C15JOSUEJOEL/CONTROL-PID-AGRO---ElECTIVA/KiCAD - Circuitos y Placas/Captura de pantalla 2026-10-22 052648.png

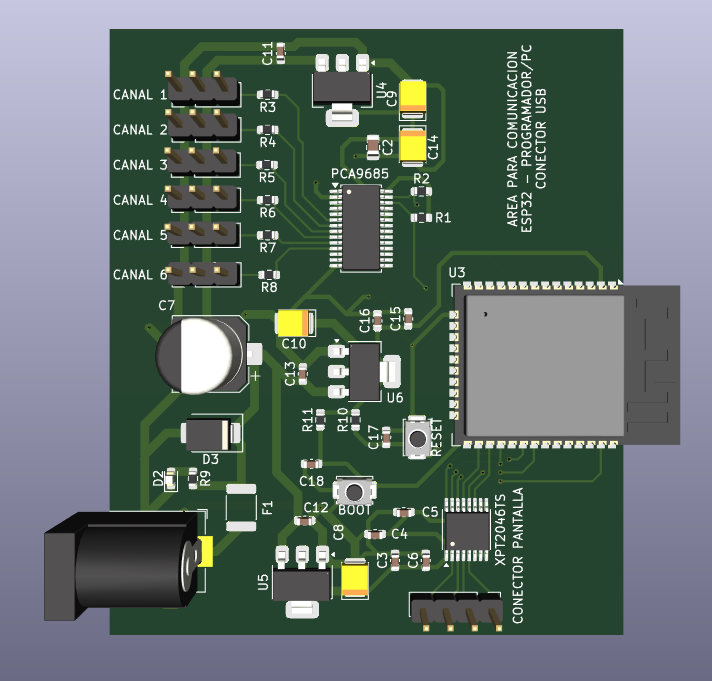
KiCAD - Circuitos y Placas/Captura de pantalla 2026-10-22 052648.png
