C15JOSUEJOEL/CONTROL-PID-AGRO---ElECTIVA/EQUIPO/Portafolio de Tareas/README

Esta seccion es un archivero para las tareas independiente o como practicas del equipo con el fin de conocer nuevos softwares durante el desarrollo del Producto AGRO
