C15JOSUEJOEL/CONTROL-PID-AGRO---ElECTIVA/EQUIPO/Portafolio de Tareas/Josue Castro, 2023-0874/CAJA de discos (Josue Castro, 2023-0874)/Piezas por partes/README

Josue Castro, 2023-0874
Adjunto partes de caja de discos y su ensamble
