C15JOSUEJOEL/CONTROL-PID-AGRO---ElECTIVA/KiCAD - Circuitos y Placas/Recursos/KH-TYPE-C-16P_kinghelm.pdf

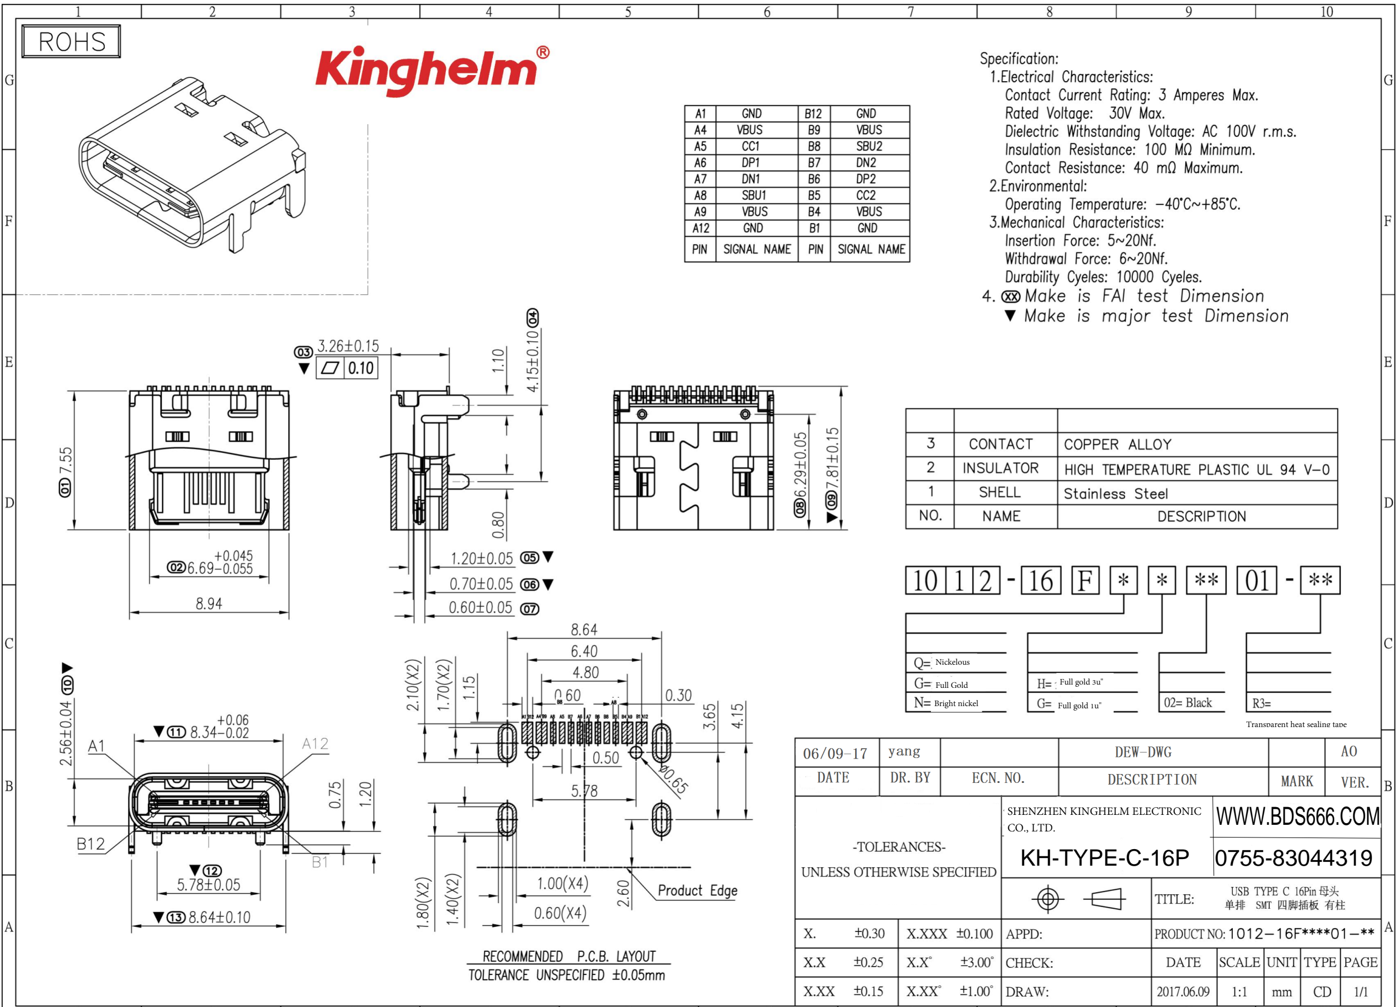
[picture p3: page 1]

深圳市金航标电子有限公司 WWW.BDS666.COM KH-TYPE-C-16P 0755-83044319
