C15JOSUEJOEL/CONTROL-PID-AGRO---ElECTIVA/Diseños 3D (FreeCad y Solid)/Refrencia para los brazos de los Servos.jpeg

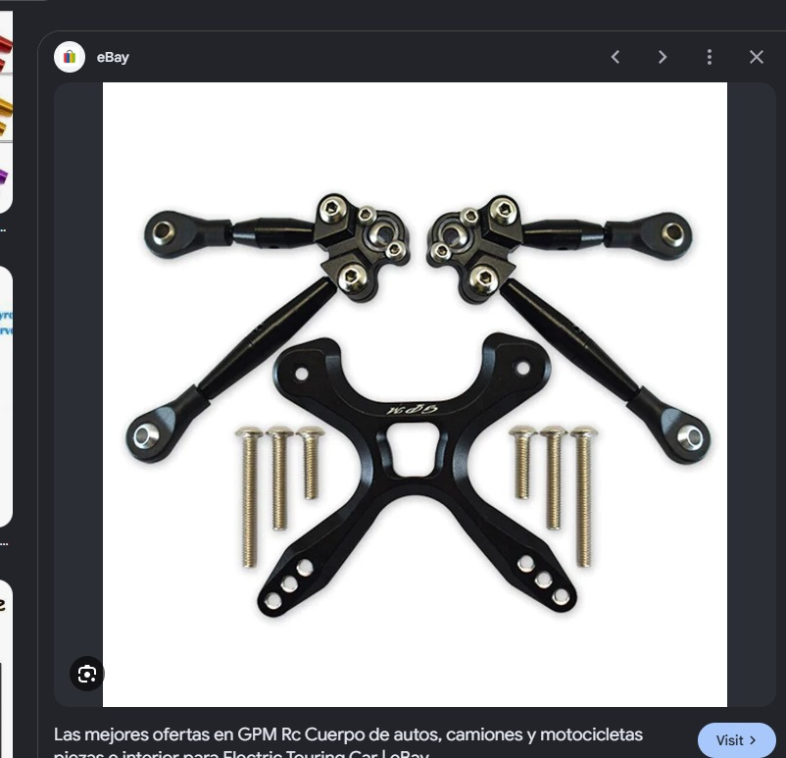
Diseños 3D (FreeCad y Solid)/Refrencia para los brazos de los Servos.jpeg
