C15JOSUEJOEL/CONTROL-PID-AGRO---ElECTIVA/EQUIPO/Portafolio de Tareas/Josue Castro, 2023-0874/CAJA de discos (Josue Castro, 2023-0874)/imagen_2026-10-20_183322660.png

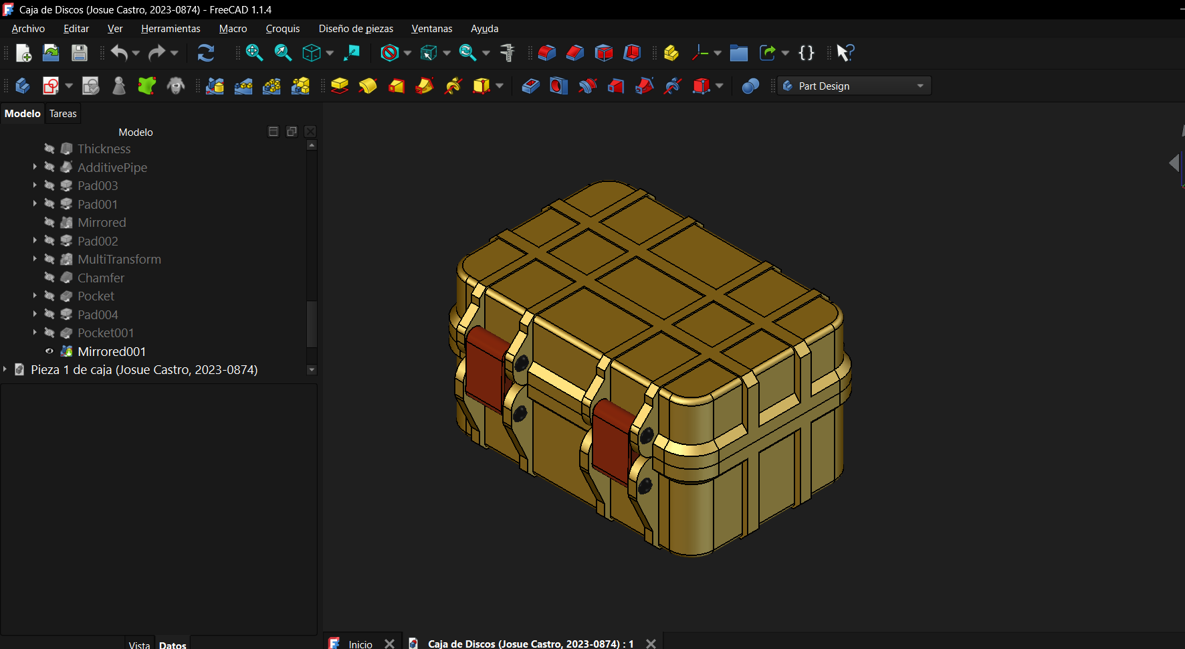
EQUIPO/Portafolio de Tareas/Josue Castro, 2023-0874/CAJA de discos (Josue Castro, 2023-0874)/imagen_2026-10-20_183322660.png
