C15JOSUEJOEL/CONTROL-PID-AGRO---ElECTIVA/KiCAD - Circuitos y Placas/Captura de pantalla 2026-11-11 192054.png

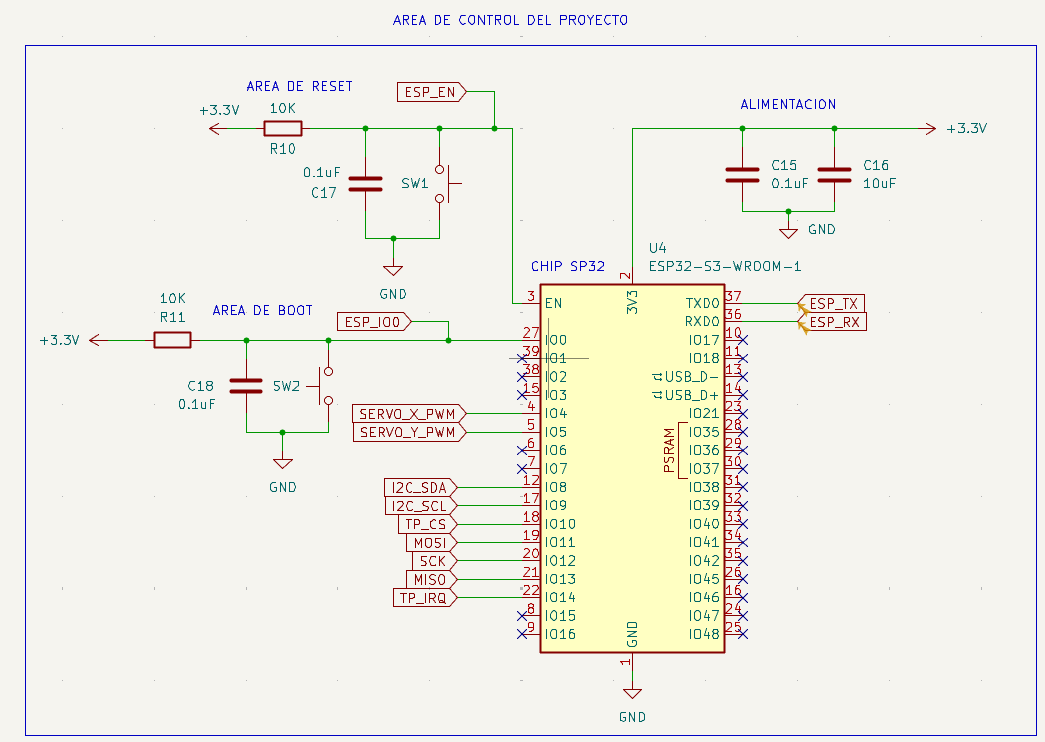
KiCAD - Circuitos y Placas/Captura de pantalla 2026-11-11 192054.png
