C15JOSUEJOEL/CONTROL-PID-AGRO---ElECTIVA/Portafolio de Tareas/Josue Castro, 2023-0874/CAJA de discos (Josue Castro, 2023-0874)/imagen_2026-10-20_184822248.png

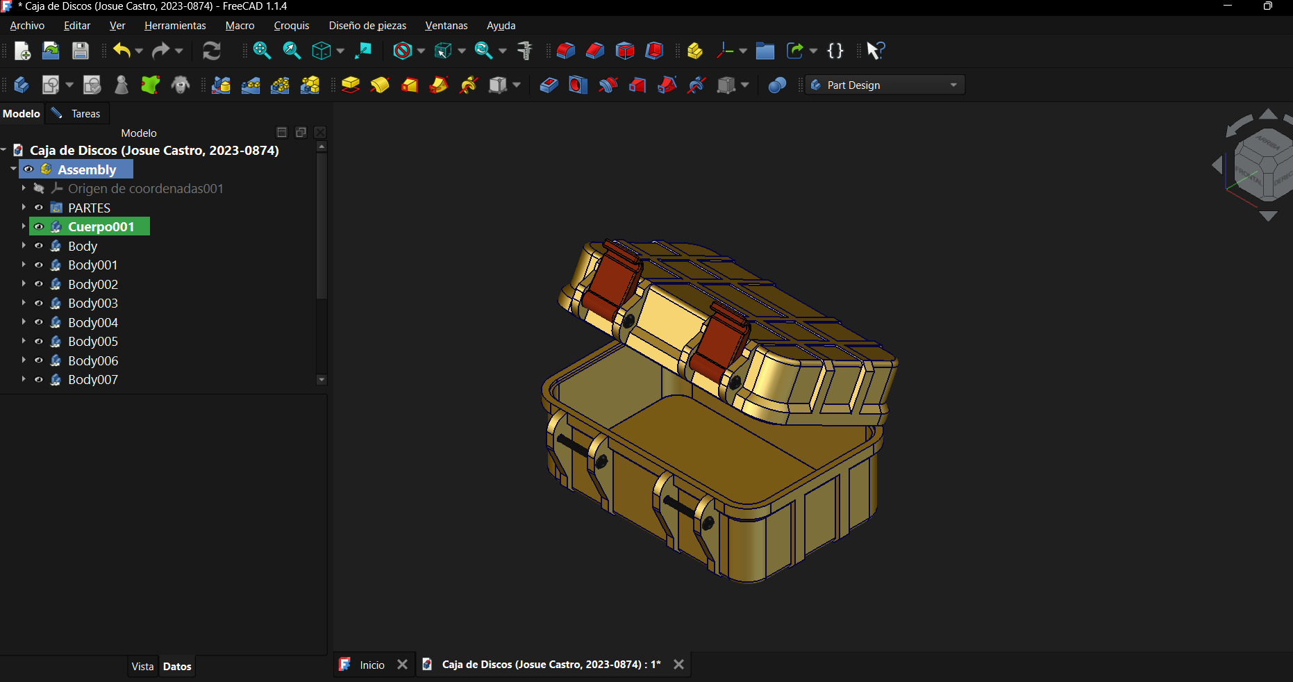
Portafolio de Tareas/Josue Castro, 2023-0874/CAJA de discos (Josue Castro, 2023-0874)/imagen_2026-10-20_184822248.png
