C15JOSUEJOEL/CONTROL-PID-AGRO---ElECTIVA/Portafolio de Tareas/Josue Castro, 2023-0874/Caja de Tronillos FreeCAD (Josue Castro, 2023-0874)/imagen_2026-10-21_192811558.png

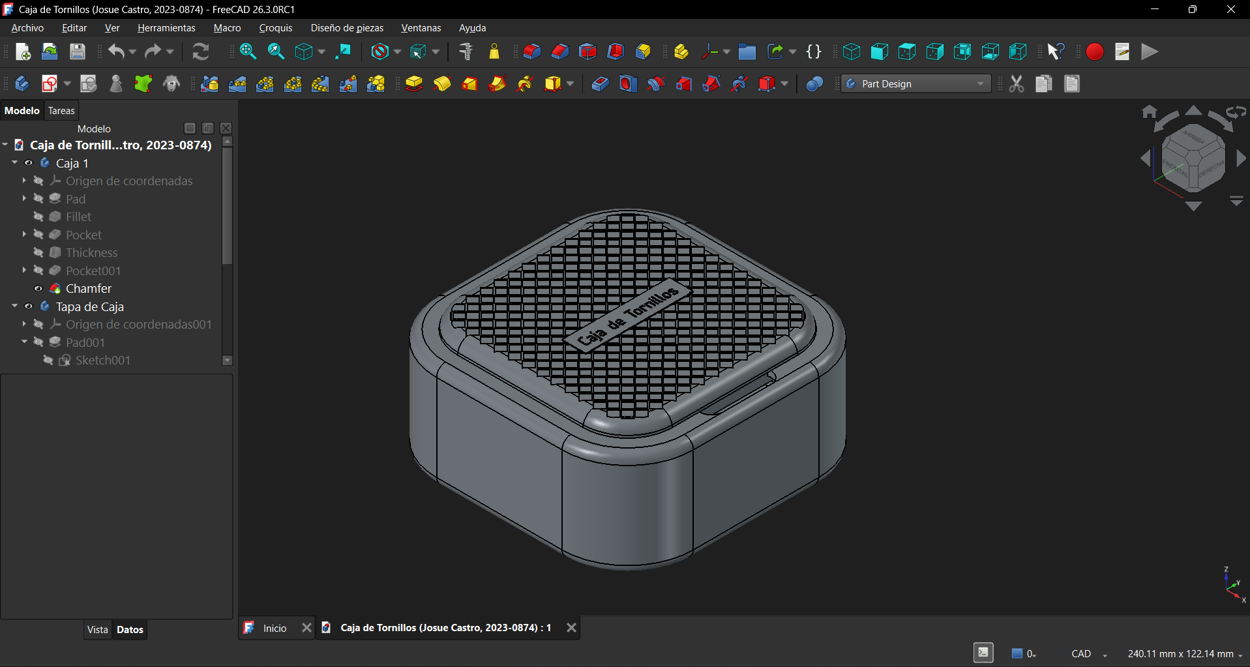
Portafolio de Tareas/Josue Castro, 2023-0874/Caja de Tronillos FreeCAD (Josue Castro, 2023-0874)/imagen_2026-10-21_192811558.png
