C15JOSUEJOEL/CONTROL-PID-AGRO---ElECTIVA/Diseños 3D (FreeCad y Solid)/Prueba PIB.STEP

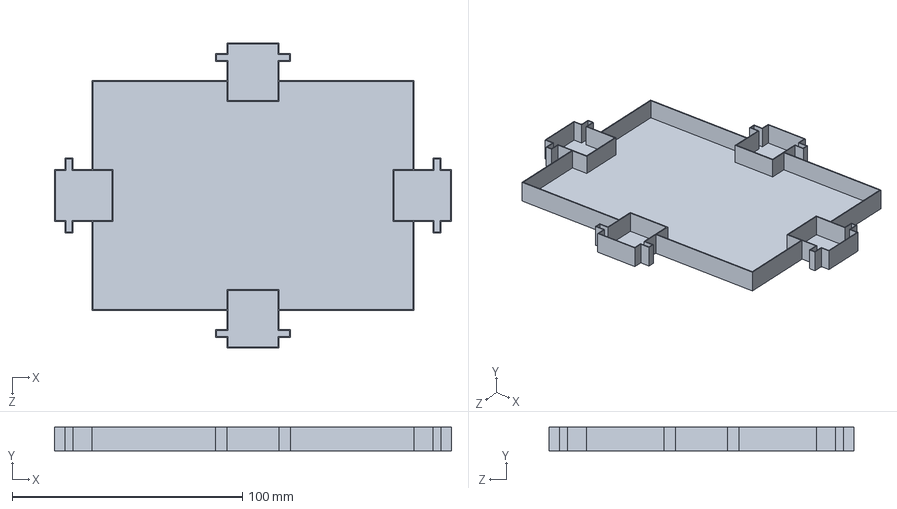
[picture p14: CAD file, 2026-11-14]
Diseños 3D (FreeCad y Solid)/Prueba PIB.STEP
172.6 x 10.3 x 132.6 mm
