C15JOSUEJOEL/CONTROL-PID-AGRO---ElECTIVA/EQUIPO/Portafolio de Tareas/Josue Castro, 2023-0874/CAJA de discos (Josue Castro, 2023-0874)/Piezas por partes/Pieza 1 de caja (Josue Castro, 2023-0874).FCStd

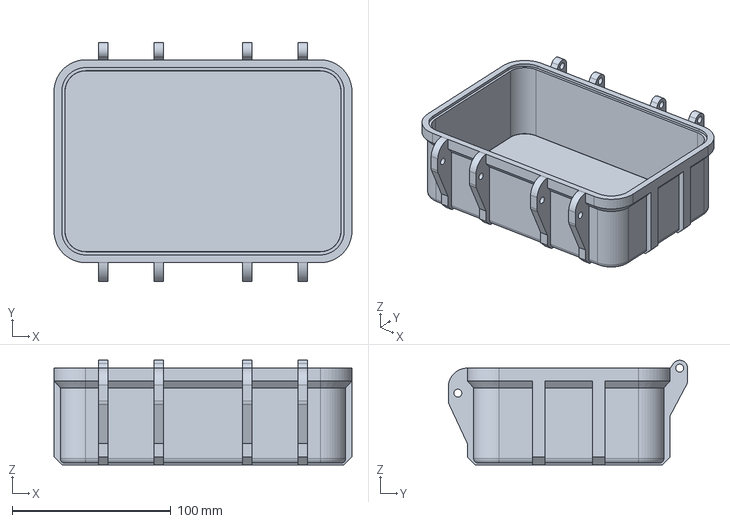
[picture p15: CAD file, 2026-11-11]
EQUIPO/Portafolio de Tareas/Josue Castro, 2023-0874/CAJA de discos (Josue Castro, 2023-0874)/Piezas por partes/Pieza 1 de caja (Josue Castro, 2023-0874).FCStd
188.0 x 150.9 x 66.0 mm
