C15JOSUEJOEL/CONTROL-PID-AGRO---ElECTIVA/EQUIPO/Portafolio de Tareas/Josue Castro, 2023-0874/Caja de Tronillos FreeCAD (Josue Castro, 2023-0874)/Caja de Tornillos (Josue Castro, 2023-0874).FCStd

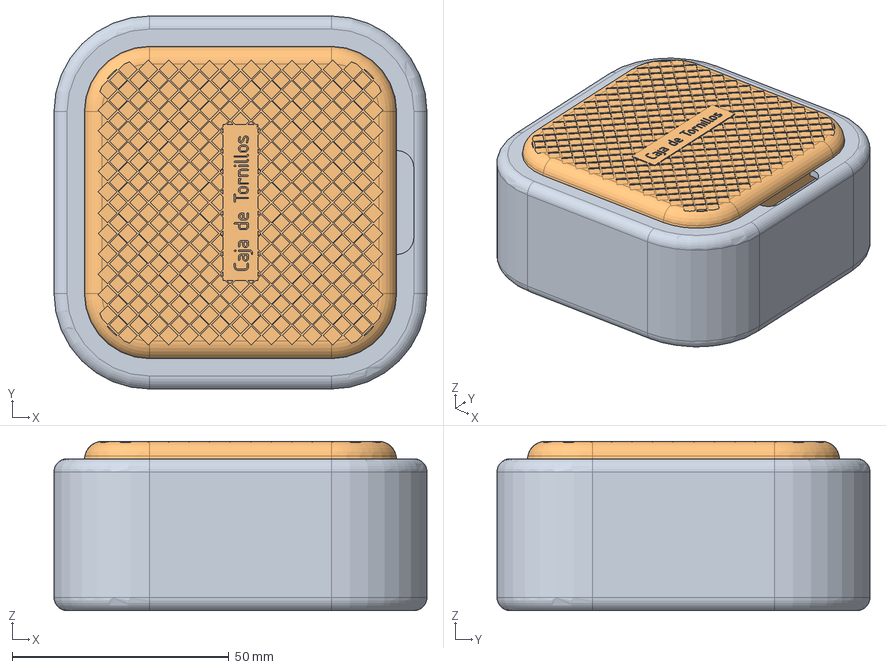
[picture p16: CAD file, 2026-11-11]
EQUIPO/Portafolio de Tareas/Josue Castro, 2023-0874/Caja de Tronillos FreeCAD (Josue Castro, 2023-0874)/Caja de Tornillos (Josue Castro, 2023-0874).FCStd
86.0 x 86.0 x 39.0 mm
Caja 1
Tapa de Caja
