C15JOSUEJOEL/CONTROL-PID-AGRO---ElECTIVA/Portafolio de Tareas/Frank Caceres 2023 0100/video2.0.FCStd

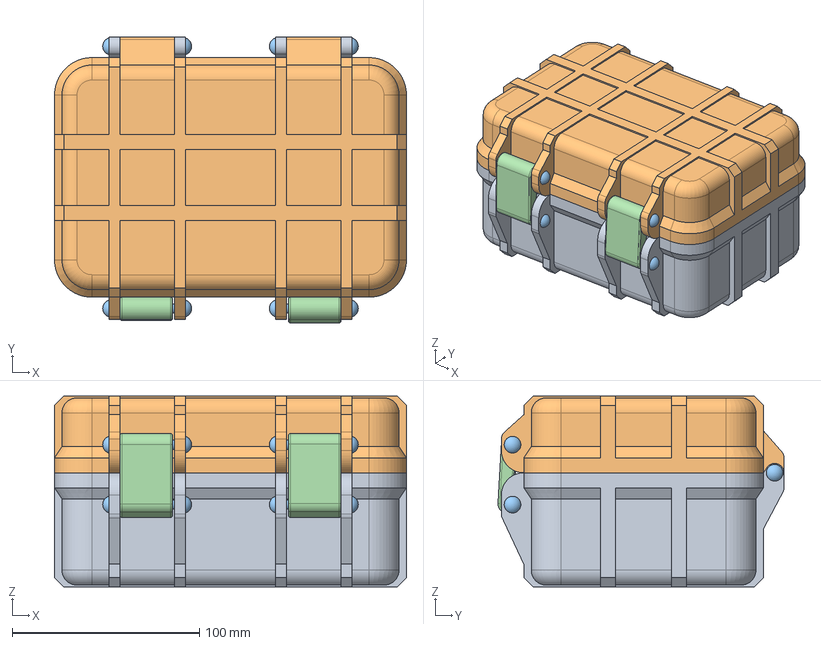
[picture p17: CAD file, 2026-10-22]
Portafolio de Tareas/Frank Caceres 2023 0100/video2.0.FCStd
188.0 x 152.8 x 102.0 mm
MAIN BODY
LID
revet x 6
