C15JOSUEJOEL/CONTROL-PID-AGRO---ElECTIVA/Portafolio de Tareas/Josue Castro, 2023-0874/CAJA de discos (Josue Castro, 2023-0874)/Piezas por partes/Pieza 2 de caja (Josue Castro, 2023-0874).FCStd

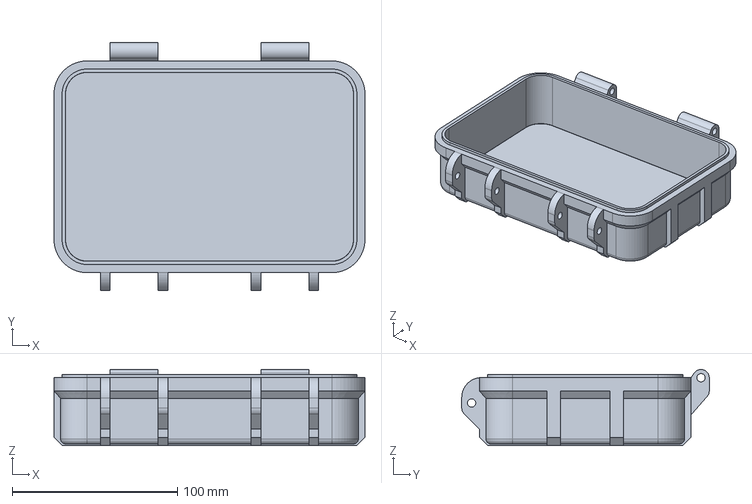
[picture p18: CAD file, 2026-10-20]
Portafolio de Tareas/Josue Castro, 2023-0874/CAJA de discos (Josue Castro, 2023-0874)/Piezas por partes/Pieza 2 de caja (Josue Castro, 2023-0874).FCStd
188.0 x 149.7 x 46.0 mm
