C15JOSUEJOEL/CONTROL-PID-AGRO---ElECTIVA/Diseños 3D (FreeCad y Solid)/PID BOSETO.FCStd

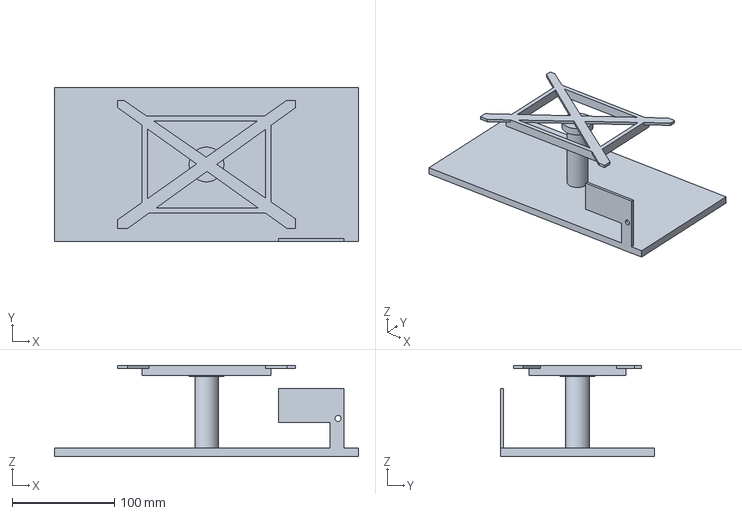
[picture p19: CAD file, 2026-11-11]
Diseños 3D (FreeCad y Solid)/PID BOSETO.FCStd
297.3 x 151.0 x 89.2 mm
