C15JOSUEJOEL/CONTROL-PID-AGRO---ElECTIVA/EQUIPO/Portafolio de Tareas/Josue Castro, 2023-0874/CAJA de discos (Josue Castro, 2023-0874)/Piezas por partes/Pieza 3 de caja (Josue Castro, 2023-0874).FCStd

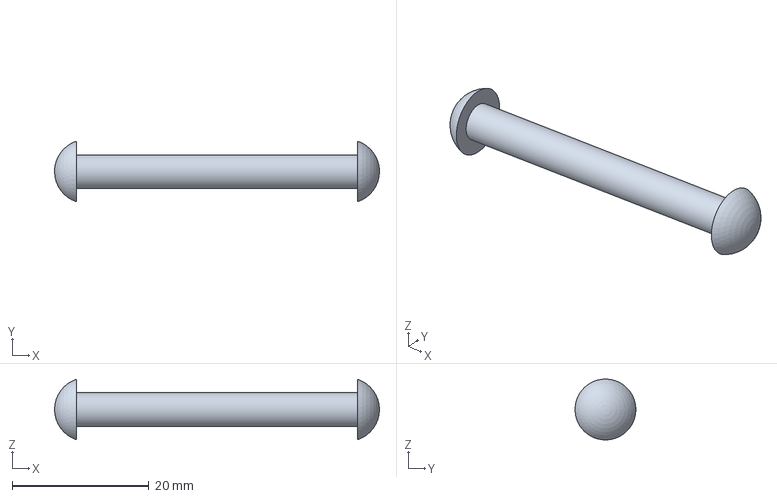
[picture p20: CAD file, 2026-11-11]
EQUIPO/Portafolio de Tareas/Josue Castro, 2023-0874/CAJA de discos (Josue Castro, 2023-0874)/Piezas por partes/Pieza 3 de caja (Josue Castro, 2023-0874).FCStd
47.5 x 8.89 x 8.90 mm
