C15JOSUEJOEL/CONTROL-PID-AGRO---ElECTIVA/Portafolio de Tareas/Josue Castro, 2023-0874/CAJA de discos (Josue Castro, 2023-0874)/Piezas por partes/Pieza 4 de caja (Josue Castro, 2023-0874).FCStd

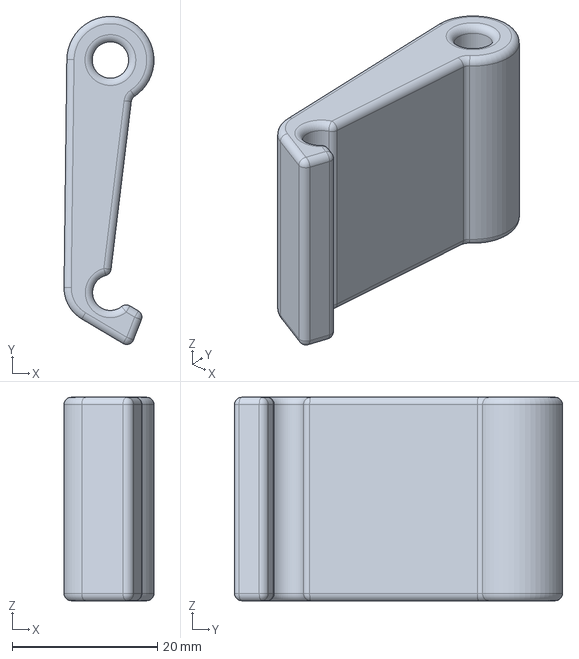
[picture p21: CAD file, 2026-10-20]
Portafolio de Tareas/Josue Castro, 2023-0874/CAJA de discos (Josue Castro, 2023-0874)/Piezas por partes/Pieza 4 de caja (Josue Castro, 2023-0874).FCStd
12.4 x 45.1 x 28.0 mm
