C15JOSUEJOEL/CONTROL-PID-AGRO---ElECTIVA/(list of files, cad)

Other CAD files:
Portafolio de Tareas/Josue Castro, 2023-0874/CAJA de discos (Josue Castro, 2023-0874)/Caja de Discos (Josue Castro, 2023-0874)a.FCStd
Portafolio de Tareas/Josue Castro, 2023-0874/CAJA de discos (Josue Castro, 2023-0874)/Caja de Discos (Josue Castro, 2023-0874).FCStd
Diseños 3D (FreeCad y Solid)/Prueba PIB.SLDPRT
