C15JOSUEJOEL/CONTROL-PID-AGRO---ElECTIVA/KiCAD - Circuitos y Placas/Control para Prototipo Balanceador AGRO/Control para Prototipo Balanceador AGRO.kicad_pcb

## KiCad design KiCAD - Circuitos y Placas/Control para Prototipo Balanceador AGRO/Control para Prototipo Balanceador AGRO.kicad_pcb (2026-10-22)

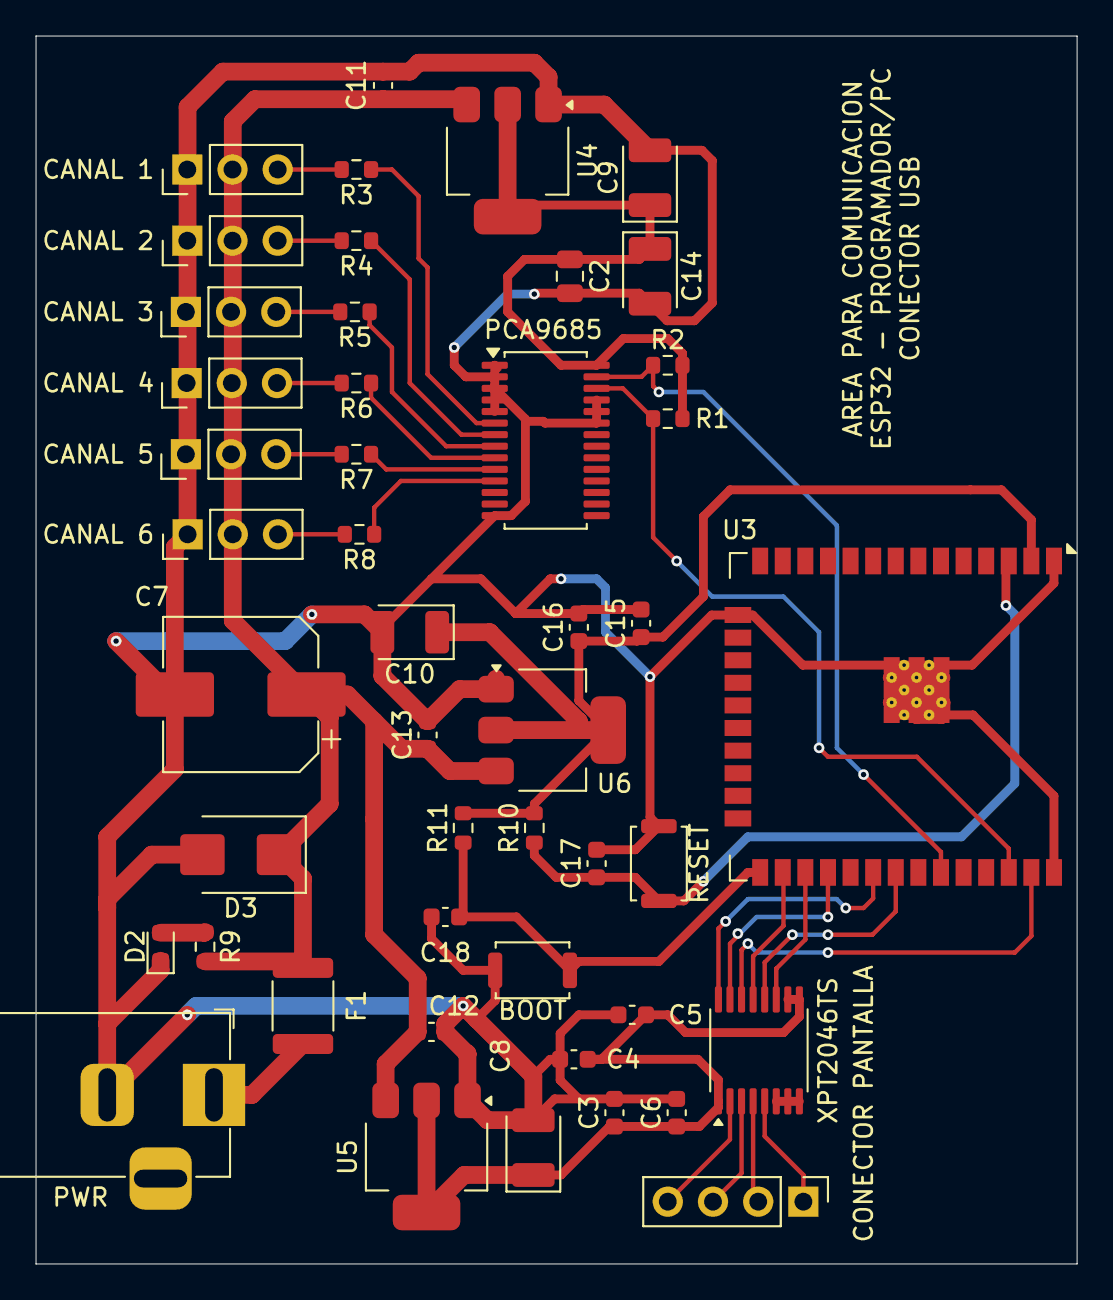
[picture p22: board Control para Prototipo Balanceador AGRO.kicad_pcb from above]

Board: 2 copper layers, 58.5 x 69.0 mm, 47 parts (0 on the bottom side), 33 nets.

Parts:
BOOT: SW_Push; SW_Push_SPST_NO_Alps_SKRK
C2: 10uF; C_0805_2012Metric
C3, C4, C5, C6, C15, C17, C18: 0.1uF; C_0603_1608Metric
C7: 1000uF; CP_Elec_8x10.5
C8, C9, C10: 22uF; CP_EIA-3528-12_Kemet-T
C11, C12, C13: 22uF; C_0603_1608Metric
C14: 100uF; CP_EIA-3528-12_Kemet-T
C16: 10uF; C_0603_1608Metric
CANAL 1, CANAL 2, CANAL 3, CANAL 4, CANAL 5, CANAL 6: Conn_01x03_Pin; PinHeader_1x03_P2.54mm_Vertical
CONECTOR PANTALLA: Conn_01x04_Pin; PinHeader_1x04_P2.54mm_Vertical
D2: LED; LED_0603_1608Metric
D3: SM6T6V8A; D_SMB
F1: 5A; Fuse_1812_4532Metric
PCA9685: PCA9685PW; TSSOP-28_4.4x9.7mm_P0.65mm
PWR: 5V_15A; BarrelJack_Horizontal
R1, R2: 4.7k; R_0603_1608Metric
R3, R4, R5, R6, R7, R8: 220; R_0603_1608Metric
R9: 1k; R_0603_1608Metric
R10, R11: 10K; R_0603_1608Metric
RESET: SW_Push; SW_Push_SPST_NO_Alps_SKRK
U3: ESP32-WROOM-32E
U4, U5, U6: AMS1117-3.3; SOT-223-3_TabPin2
XPT2046TS: XPT2046TS; TSSOP-16_4.4x5mm_P0.65mm

Connections:
+5V: C7.1, C11.1, C12.1, C13.1, CANAL 1.2, CANAL 2.2, CANAL 3.2, CANAL 4.2, CANAL 5.2, CANAL 6.2, D3.1 (A1), F1.1, R9.2, U4.3 (VI), U5.3 (VI), U6.3 (VI)
GND: BOOT.2, C2.2, C3.2, C4.2, C5.2, C6.2, C7.2, C8.2, C9.2, C10.2, C11.2, C12.2, C13.2, C14.2, C15.2, C16.2, C17.2, C18.2, CANAL 1.1, CANAL 2.1, CANAL 3.1, CANAL 4.1, CANAL 5.1, CANAL 6.1, D2.1 (K), D3.2 (A2), PCA9685.1 (A0), PCA9685.2 (A1), PCA9685.3 (A2), PCA9685.4 (A3), PCA9685.5 (A4), PCA9685.14 (VSS), PCA9685.23 (~OE), PCA9685.24 (A5), PCA9685.25 (EXTCLK), PWR.2, RESET.1, U3.1 (GND), U3.15 (GND), U3.38 (GND), U3.39 (GND), U4.1 (GND), U5.1 (GND), U6.1 (GND), XPT2046TS.6 (GND), XPT2046TS.7 (VBAT), XPT2046TS.8 (IN)
I2C_SCL: PCA9685.26 (SCL), R1.1, U3.36 (IO22)
I2C_SDA: PCA9685.27 (SDA), R2.1, U3.33 (IO21)
MISO: U3.31 (IO19), XPT2046TS.12 (DOUT)
MOSI: U3.37 (IO23), XPT2046TS.14 (DIN)
unnamed: D2.2 (A), R9.1
unnamed: F1.2, PWR.1
unnamed: PCA9685.6 (LED0), R3.1
unnamed: PCA9685.7 (LED1), R4.1
unnamed: PCA9685.8 (LED2), R5.1
unnamed: PCA9685.9 (LED3), R6.1
unnamed: PCA9685.10 (LED4), R7.1
unnamed: PCA9685.11 (LED5), R8.1
unnamed: C17.1, R10.1, RESET.2, U3.3 (EN)
unnamed: BOOT.1, C18.1, R11.1, U3.25 (IO0)
POWER_C_SERVO_3.3V: C2.1, C9.1, C14.1, PCA9685.28 (VDD), R1.2, R2.2, U4.2 (VO)
POWER_ESP32_3.3V: C10.1, C15.1, C16.1, R10.2, R11.2, U3.2 (VDD), U6.2 (VO)
POWER_SCREEN_3.3V: C3.1, C4.1, C5.1, C6.1, C8.1, U5.2 (VO), XPT2046TS.1 (VCC), XPT2046TS.9 (VREF), XPT2046TS.10 (IOVDD)
SCK: U3.30 (IO18), XPT2046TS.16 (DCLK)
SERVO1_SIG: CANAL 1.3, R3.2
SERVO2_SIG: CANAL 2.3, R4.2
SERVO3_SIG: CANAL 3.3, R5.2
SERVO4_SIG: CANAL 4.3, R6.2
SERVO5_SIG: CANAL 5.3, R7.2
SERVO6_SIG: CANAL 6.3, R8.2
TP_BUSY: U3.26 (IO4), XPT2046TS.13 (BUSY)
TP_CS: U3.28 (IO17), XPT2046TS.15 (~CS)
TP_IRQ: U3.27 (IO16), XPT2046TS.11 (~PENIRQ)
X+: CONECTOR PANTALLA.4, XPT2046TS.2 (XP)
X-: CONECTOR PANTALLA.2, XPT2046TS.4 (XN)
Y+: CONECTOR PANTALLA.3, XPT2046TS.3 (YP)
Y-: CONECTOR PANTALLA.1, XPT2046TS.5 (YN)
