C15JOSUEJOEL/CONTROL-PID-AGRO---ElECTIVA/KiCAD - Circuitos y Placas/Control para Prototipo Balanceador AGRO 2.0/Control para Prototipo Balanceador AGRO 2.01.kicad_pcb

## KiCad design KiCAD - Circuitos y Placas/Control para Prototipo Balanceador AGRO 2.0/Control para Prototipo Balanceador AGRO 2.01.kicad_pcb (2026-11-12)

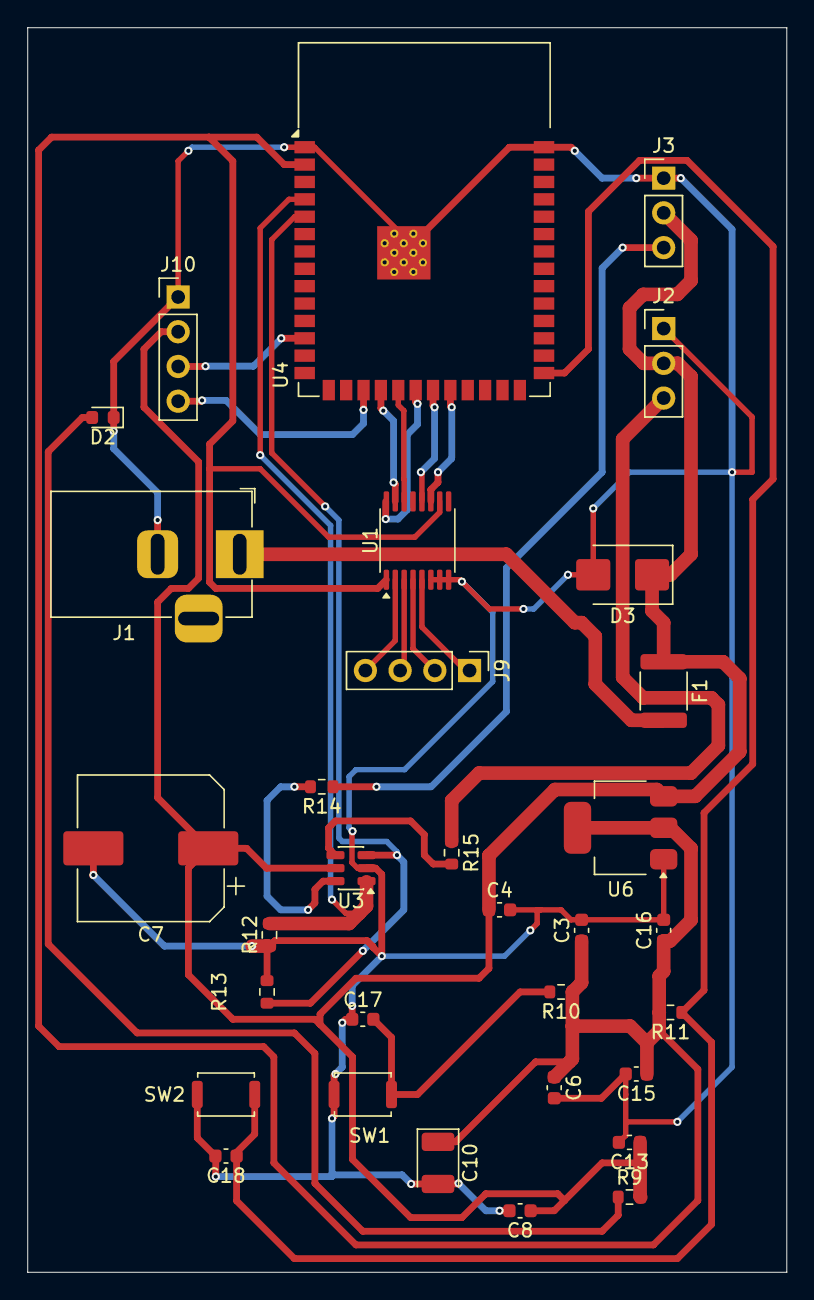
[picture p23: board Control para Prototipo Balanceador AGRO 2.01.kicad_pcb from above]

Board: 2 copper layers, 55.5 x 91.0 mm, 32 parts (0 on the bottom side), 24 nets.

Parts:
C3, C8, C15, C17, C18: 0.1uF; C_0603_1608Metric
C4, C6, C16: 10uF; C_0603_1608Metric
C7: 1000uF; CP_Elec_10x10.5
C10: 22uF; CP_EIA-3528-21_Kemet-B
C13: 22uF; C_0603_1608Metric
D2: LED; LED_0603_1608Metric
D3: SM6T6V8A; D_SMB
F1: 5A; Fuse_1812_4532Metric
J1: 5V_15A; BarrelJack_Horizontal
J2: Conector_Y; PinHeader_1x03_P2.54mm_Vertical
J3: Conector_X; PinHeader_1x03_P2.54mm_Vertical
J9, J10: Conn_01x04_Pin; PinHeader_1x04_P2.54mm_Vertical
R9: 1k; R_0603_1608Metric
R10, R11, R12, R13: 10K; R_0603_1608Metric
R14, R15: 220; R_0603_1608Metric
SW1, SW2: SW_Push; SW_Push_SPST_NO_Alps_SKRK
U1: TSC2046IPW; TSSOP-16_4.4x5mm_P0.65mm
U3: 74HCT2G34; SOT-23-6
U4: ESP32-S3-WROOM-1
U6: AMS1117-3.3; SOT-223-3_TabPin2

Connections:
+3.3V: C3.1, C6.1, C10.1, C15.1, C16.1, R10.1, R11.2, U1.1 (VCC+), U1.10 (IOVDD), U4.2 (3V3), U6.2 (VO)
+5V: C4.1, C7.1, C8.1, C13.1, D3.1 (A1), F1.1, J2.2, J3.2, J10.2, R9.2, U3.5 (VCC), U6.3 (VI)
CHIP_1A: R12.2, U3.1 (1A), U4.4 (IO4)
CHIP_2A: R13.2, U3.3 (2A), U4.5 (IO5)
ESP_EN: C17.2, R10.2, SW1.1, U4.3 (EN)
ESP_IO0: C18.1, R11.1, SW2.1, U4.27 (IO0)
GND: C3.2, C4.2, C6.2, C7.2, C8.2, C10.2, C13.2, C15.2, C16.2, C17.1, C18.2, D2.1 (K), D3.2 (A2), J1.2, J2.1, J3.1, J10.1, R12.1, R13.1, SW1.2, SW2.2, U1.6 (GND), U1.7 (VBAT), U1.8 (AUX), U3.2 (GND), U4.1 (GND), U4.40 (GND), U4.41 (GND), U6.1 (GND)
I2C_SCL: J10.4, U4.17 (IO9)
I2C_SDA: J10.3, U4.12 (IO8)
MISO: U1.12 (DOUT), U4.21 (IO13)
MOSI: U1.14 (DIN), U4.19 (IO11)
unnamed: D2.2 (A), R9.1
unnamed: F1.2, J1.1
unnamed: R14.2, U3.6 (1Y)
unnamed: R15.2, U3.4 (2Y)
SCK: U1.16 (DCLK), U4.20 (IO12)
Servo_Motor_X_Signal: J3.3, R14.1
Servo_Motor_Y_Signal: J2.3, R15.1
TP_CS: U1.15 (*CS), U4.18 (IO10)
TP_IRQ: U1.11 (*PENIRQ), U4.22 (IO14)
X+: J9.4, U1.2 (X+)
X-: J9.2, U1.4 (X-)
Y+: J9.3, U1.3 (Y+)
Y-: J9.1, U1.5 (Y-)
