C15JOSUEJOEL/CONTROL-PID-AGRO---ElECTIVA/(commit log)

2026-10-15 Ficha de Instrumentacion
2026-11-05 Rename Desarrollo de Producto Basada Norma IEEE-830 STD (Grupo AGRO).docx to DOCUMENTOS/Desarrollo de Producto Basada Norma IEEE-830 STD (Grupo AGRO).docx
2026-11-05 Rename Desarrollo de Producto Basada Norma IEEE-830 STD (Grupo AGRO).pdf to DOCUMENTOS/Desarrollo de Producto Basada Norma IEEE-830 STD (Grupo AGRO).pdf
2026-11-05 Rename Preguntas del Proyecto CONTROL PID.txt to DOCUMENTOS/Preguntas del Proyecto CONTROL PID.txt
2026-11-11 Haciendo los cambios de la ultima revision
2026-11-11 Agredando cambios a la placa y los bocetos del proyecto
2026-11-11 Haciendo ajustes a al digarama y algunos recursos
    -Solo cambios en el diagrama
    -Agregando algunos datasheets nuevos
2026-11-12 ENRUTAMIENTO PCB
2026-11-14 Cambios del Proyecto
    -Arreglos al esquematico
    -arreglos al diseno
    -cambios de logica del equematico
2026-11-14 Cambios al esquemático
    - solo se agregaron los mods
    - conexion USB C al ESP32
    -toques finales para el enrutado de la PCB
